Pontifex42/Walldraw/ESP32/Media/IMG_20220801_133036.jpg

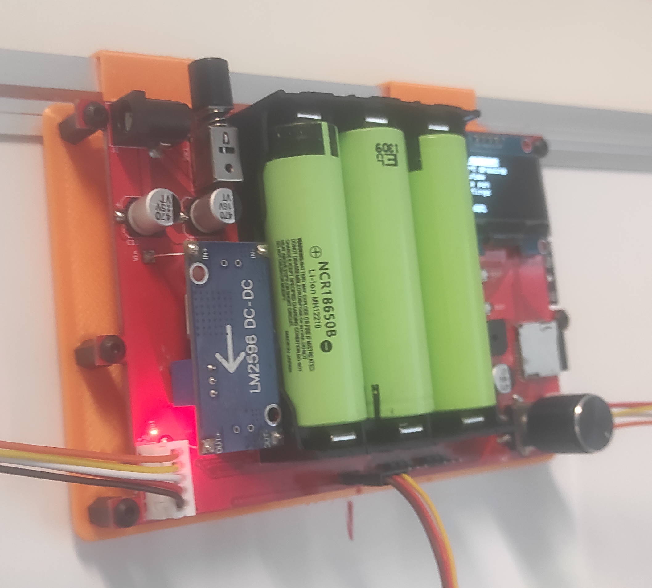
ESP32/Media/IMG_20220801_133036.jpg
