Pontifex42/Walldraw/README.md

# Walldraw
Vollständige Anleitung auf Deutsch ist in "Wandplotter.pdf".
Find a german manual in the file "Wandplotter.pdf".
