Pontifex42/Walldraw/ESP32/Media/IMG_20220804_125302.jpg

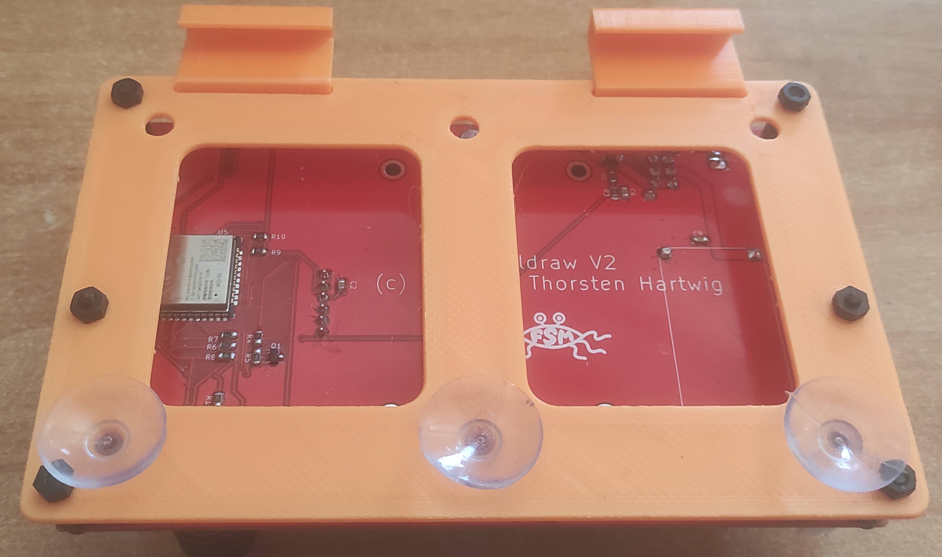
ESP32/Media/IMG_20220804_125302.jpg
