Pontifex42/Walldraw/Media/IMG_20220721_150740.jpg

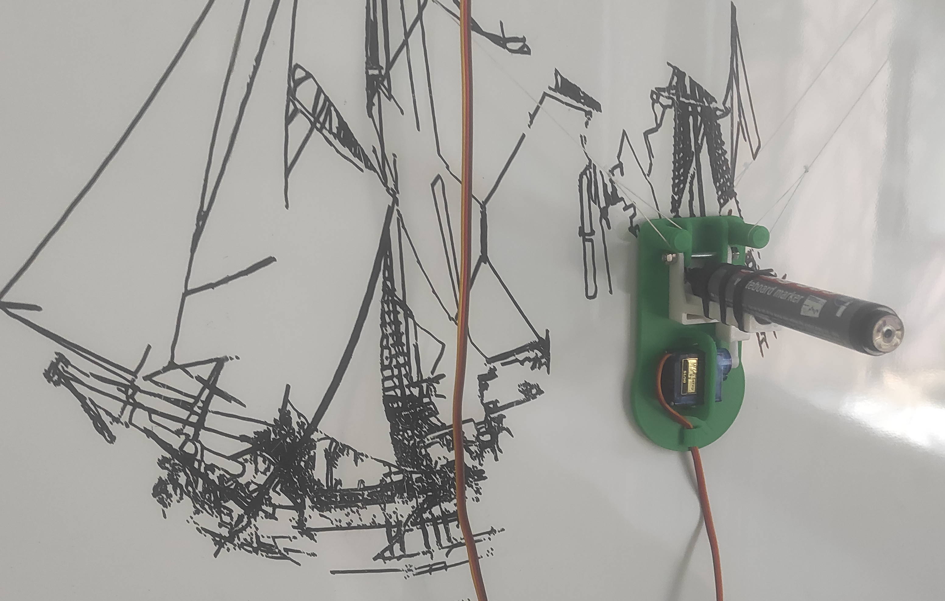
Media/IMG_20220721_150740.jpg
