Pontifex42/Walldraw/Media/IMG_20220801_133017.jpg

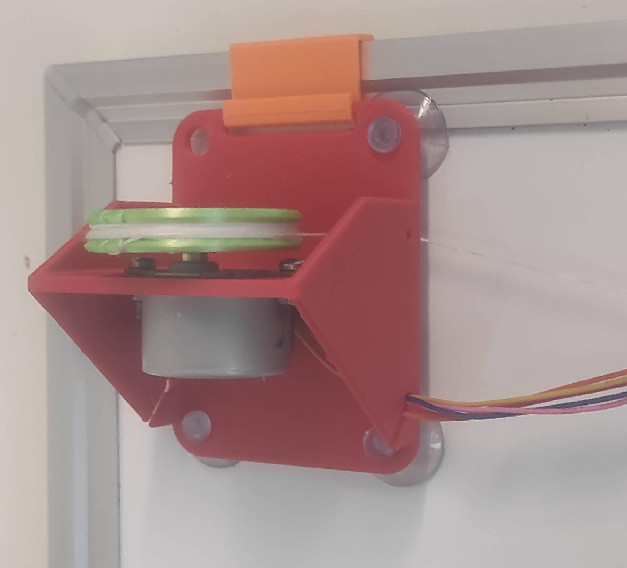
Media/IMG_20220801_133017.jpg
