Pontifex42/Walldraw/Media/IMG_20220801_133601.jpg

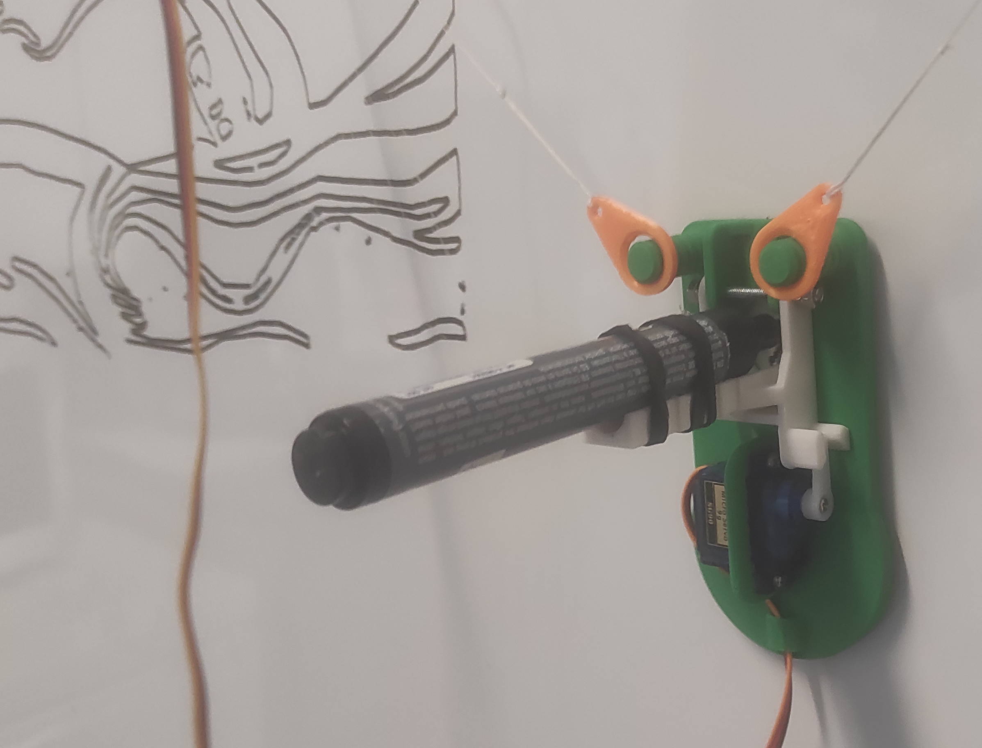
Media/IMG_20220801_133601.jpg
