Pontifex42/Walldraw/UNO/Media/IMG_20220723_133455.jpg

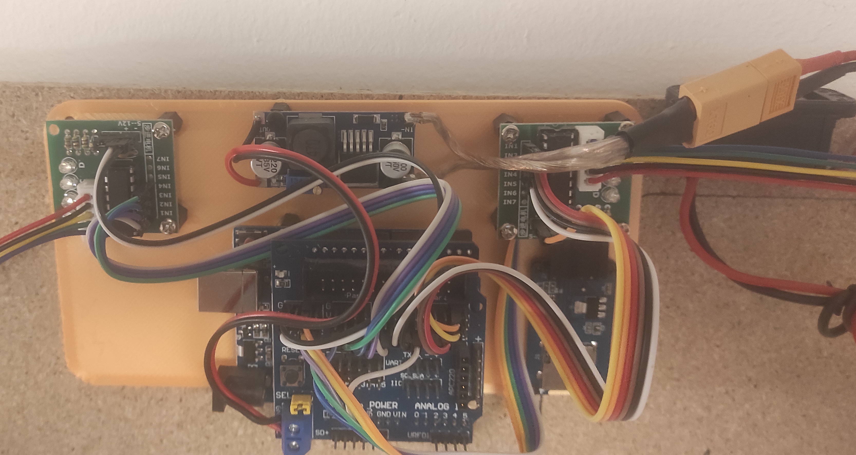
UNO/Media/IMG_20220723_133455.jpg
