Pontifex42/Walldraw/UNO/Media/IMG_20220723_133458.jpg

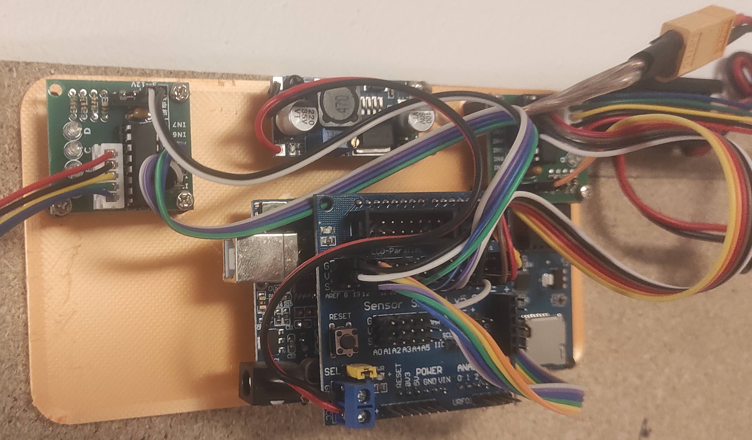
UNO/Media/IMG_20220723_133458.jpg
