Pontifex42/Walldraw/PartList.htm

 | Walldraw Parts List
 |  |  |  | Source
Both Variants
 | Servo Sledge | 1 |  | 3D-Printed
 | Pen Holder (Lever) | 1 |  | 3D-Printed
 | Stepper holder | 2 |  | 3D-Printed
 | Spool | 2 |  | 3D-Printed
 | Base plate (either UNO or ESP32 Variant) | 1 |  | 3D-Printed
 | Twine rings | 2 |  | 3D-Printed
 | Cable clamps | 4 |  | 3D-Printed
 | Hooks | 4 |  | 3D-Printed
 | Motor 28BYJ-48 5V | 2 |  | https://de.aliexpress.com/wholesale?&SearchText=28BYJ-48
 | Motor cable 50cm | 2 |  | https://de.aliexpress.com/item/4000407576136.html or solder yourself
 | Screws M3x10 | 6 |  | To attach motors and pen lever
 | Servo SG90 | 1 |  | https://de.aliexpress.com/wholesale?&SearchText=SG90
 | Servo cable 100cm | 1 |  | https://de.aliexpress.com/item/32902360371.html or solder yourself
 | PCB Mounting material kit | 1 |  | https://de.aliexpress.com/wholesale?&SearchText=pcb+mount+kit
 | Ink Pen | 1 |  | Any store
 | Twine 3m | 2 |  | Look in mummys sewing kit
 | Rubber straps to mount pen | 4 |  | Look in mummys sewing kit
 | microSD Card e.g. 2GB | 1 |  | Any electronics store
 | Sucker | 14 | Optional | https://de.aliexpress.com/wholesale?&SearchText=saugnapf
UNO Variant
 | Motor Driver Board ULN2003 | 2 |  | included in motor
 | microSD Card reader | 1 |  | https://de.aliexpress.com/item/32523546123.html
 | Arduino Uno R3 | 1 |  | https://de.aliexpress.com/item/1005002707450245.html
 | Arduino Sensor Shield V5.0 | 1 |  | https://de.aliexpress.com/item/32552605782.html
 | Screws <2mm x 3mm to mount SD cardreader | 2 |  | Hot glue may do a s well
 | 5V 2A Power Supply with DC Plug 5,5mm | 1 | Alternativ | https://de.aliexpress.com/wholesale?&SearchText=power+5V+5.5mm
 | LM2596 DC-DC Buck Converter 3A (also on ESP32 PCB) | 1 | Alternativ | https://de.aliexpress.com/item/32272430344.html
 | XT60 Connector, optional | 1 | Optional | https://de.aliexpress.com/item/32920591260.html
 | XT60 Switch, optional | 1 | Optional | https://de.aliexpress.com/item/1005001705864141.html
 | LiPo Battery 11,2V 2Ah w. XT60 Connector, optional | 1 | Alternativ
 | Don‘t forget you need a LiPo Charger | 1 | Optional
 | There is currently no plan for wiring. Look into code.
ESP32 variant
 | LiIon 18650 batteries (or 12V power supply) | 3 | Alternativ | https://de.aliexpress.com/wholesale?&SearchText=18650+panasonic
 | Alternativ: 12V 2A power supply with DC5.5mm connector | 1 | Alternativ | https://de.aliexpress.com/wholesale?&SearchText=power+DC+12V+2A+5.5mm
 | PCB, e.g. from JLCPCB or PCBWAY using contained Gerber files | 1 |  | https://jlcpcb.com/
 | PCB parts as listed in the file „ibom.html“, see there | A lot |  | See part list there
 | FTDI-Adapter 3.3V | 1 |  | https://de.aliexpress.com/wholesale?&SearchText=FTDI
Software
 | Arduino IDE |  |  | https://www.arduino.cc/
 | Alternativ: Microsoft Visual Studio and vsmicro extension |  | Optional | https://www.visualmicro.com/, 45Days trial, than $12/year
 | ESP32 Board Manager V2.x |  |  | Install using board manager of Arduino IDE
 | Inkscape |  |  | https://inkscape.org, Find tutorials to convert drawings to gcode on YT
 | Walldraw code from my github |  |  | https://github.com/Pontifex42/Walldraw
 | Picture resizer tool, use the generated executable |  |  | https://github.com/Pontifex42/Walldraw
