Pontifex42/Walldraw/3DFiles/TwineRing.stl

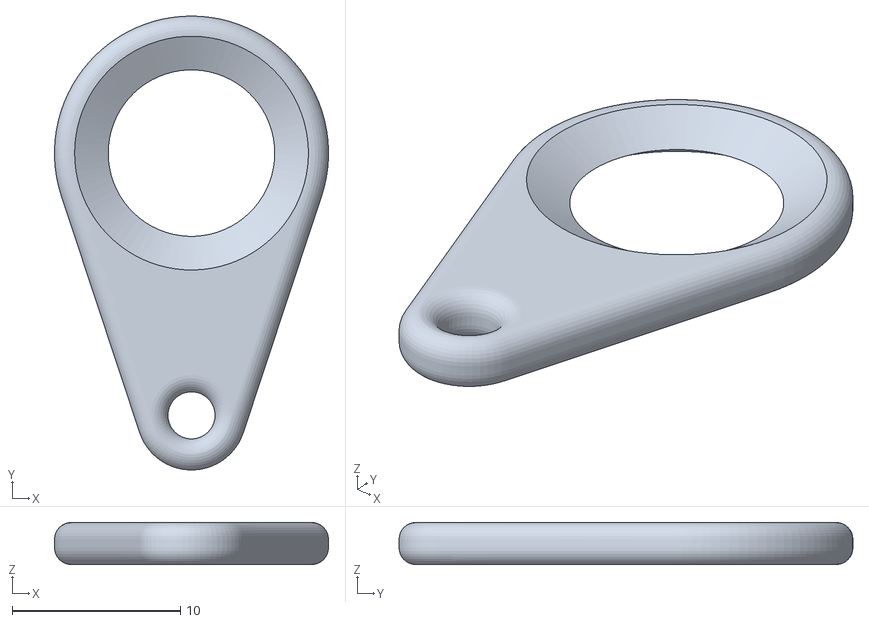
[picture p15: CAD file, 2022-08-04]
3DFiles/TwineRing.stl
16.3 x 27.0 x 2.50
