Pontifex42/Walldraw/3DFiles/StepperStand.stl

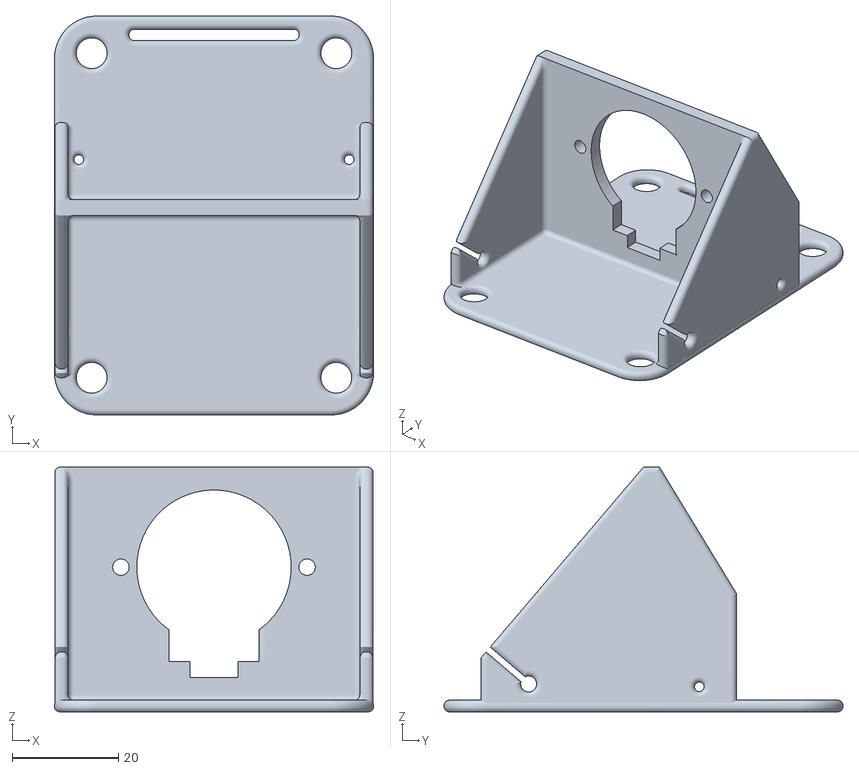
[picture p16: CAD file, 2022-08-04]
3DFiles/StepperStand.stl
60.0 x 75.0 x 46.0
