Pontifex42/Walldraw/3DFiles/Spool.stl

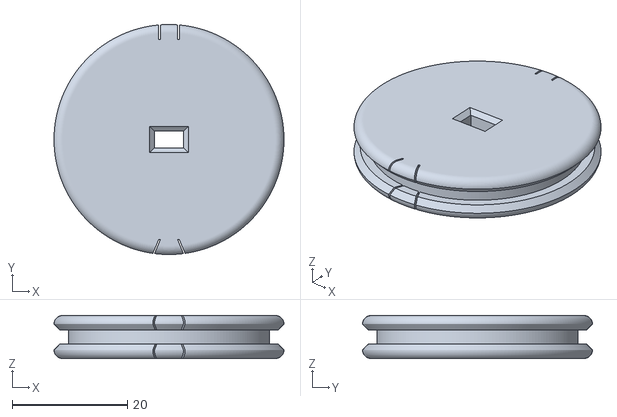
[picture p17: CAD file, 2022-08-04]
3DFiles/Spool.stl
40.0 x 40.0 x 7.50
