Pontifex42/Walldraw/3DFiles/Lever.stl

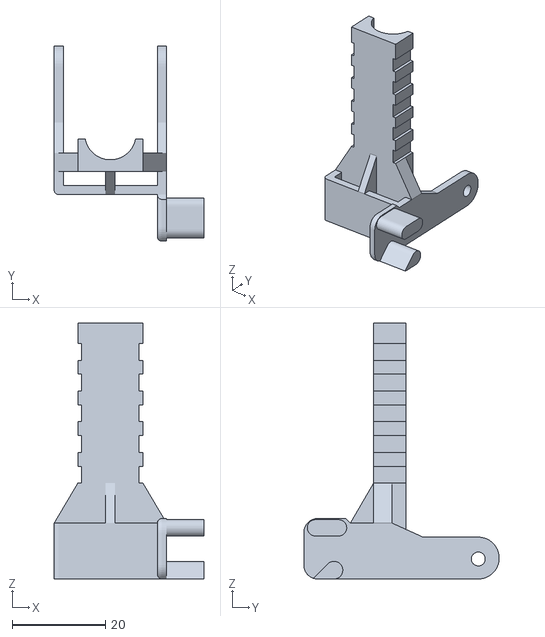
[picture p18: CAD file, 2022-08-04]
3DFiles/Lever.stl
32.2 x 42.0 x 55.0
