Pontifex42/Walldraw/3DFiles/WireClamp.stl

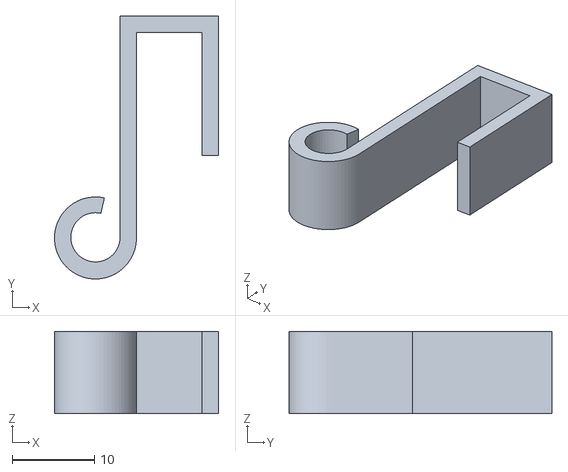
[picture p19: CAD file, 2022-08-04]
3DFiles/WireClamp.stl
20.0 x 32.1 x 10.0
