Pontifex42/Walldraw/3DFiles/Sledge.stl

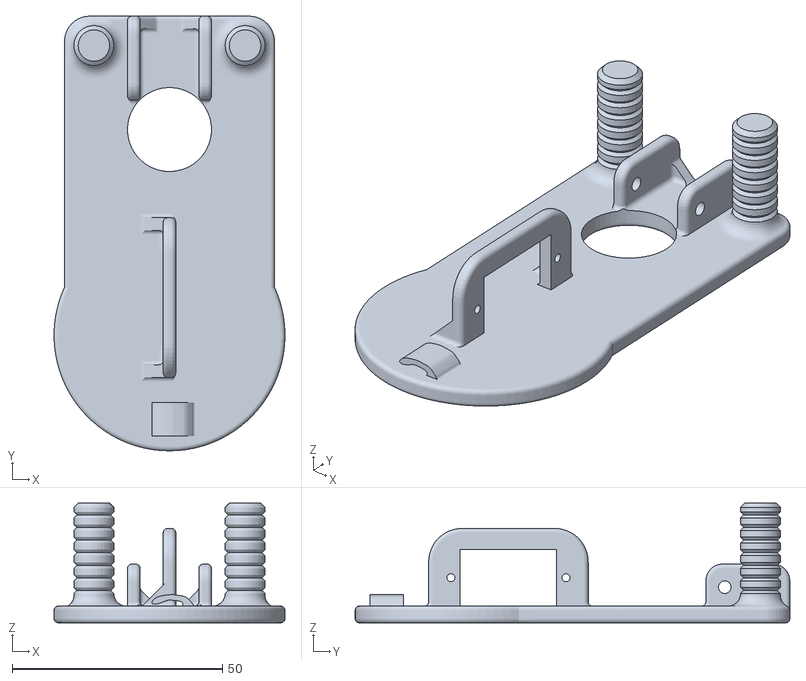
[picture p20: CAD file, 2022-08-04]
3DFiles/Sledge.stl
55.0 x 103.5 x 28.5
