Pontifex42/Walldraw/3DFiles/BasePlate Uno.stl

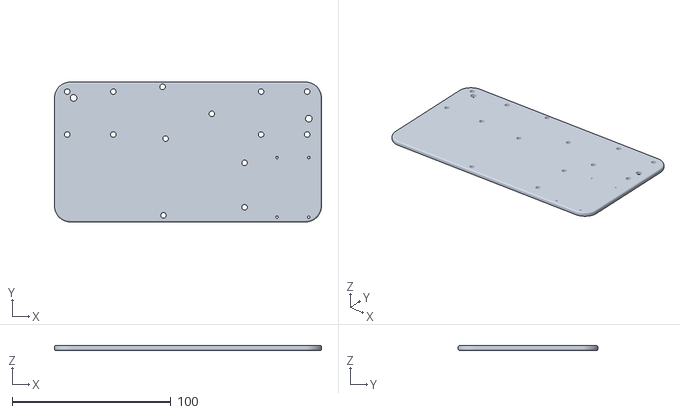
[picture p21: CAD file, 2022-08-04]
3DFiles/BasePlate Uno.stl
168.0 x 88.0 x 3.20
