Pontifex42/Walldraw/3DFiles/BasePlate PCB.stl

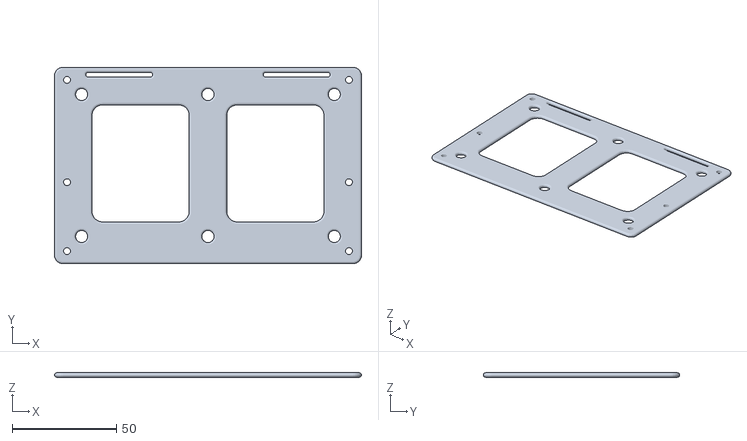
[picture p22: CAD file, 2022-08-04]
3DFiles/BasePlate PCB.stl
147.0 x 94.0 x 2.20
