Pontifex42/Walldraw/3DFiles/Hook.stl

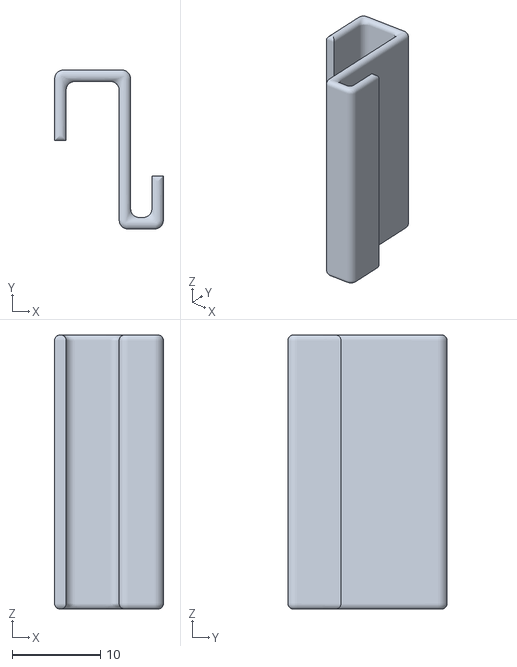
[picture p23: CAD file, 2022-08-04]
3DFiles/Hook.stl
12.3 x 18.0 x 31.0
