Pontifex42/Walldraw/(list of files, cad)

Other CAD files:
3DFiles/BasePlate.f3d
3DFiles/Sledge.f3d
3DFiles/Spool.f3d
3DFiles/StepperStand.f3d
3DFiles/WireClamp.f3d
