Pontifex42/Walldraw/ESP32/KiCad/WallDraw/WallDraw.kicad_pcb

## KiCad design ESP32/KiCad/WallDraw/WallDraw.kicad_pcb (2022-08-04)

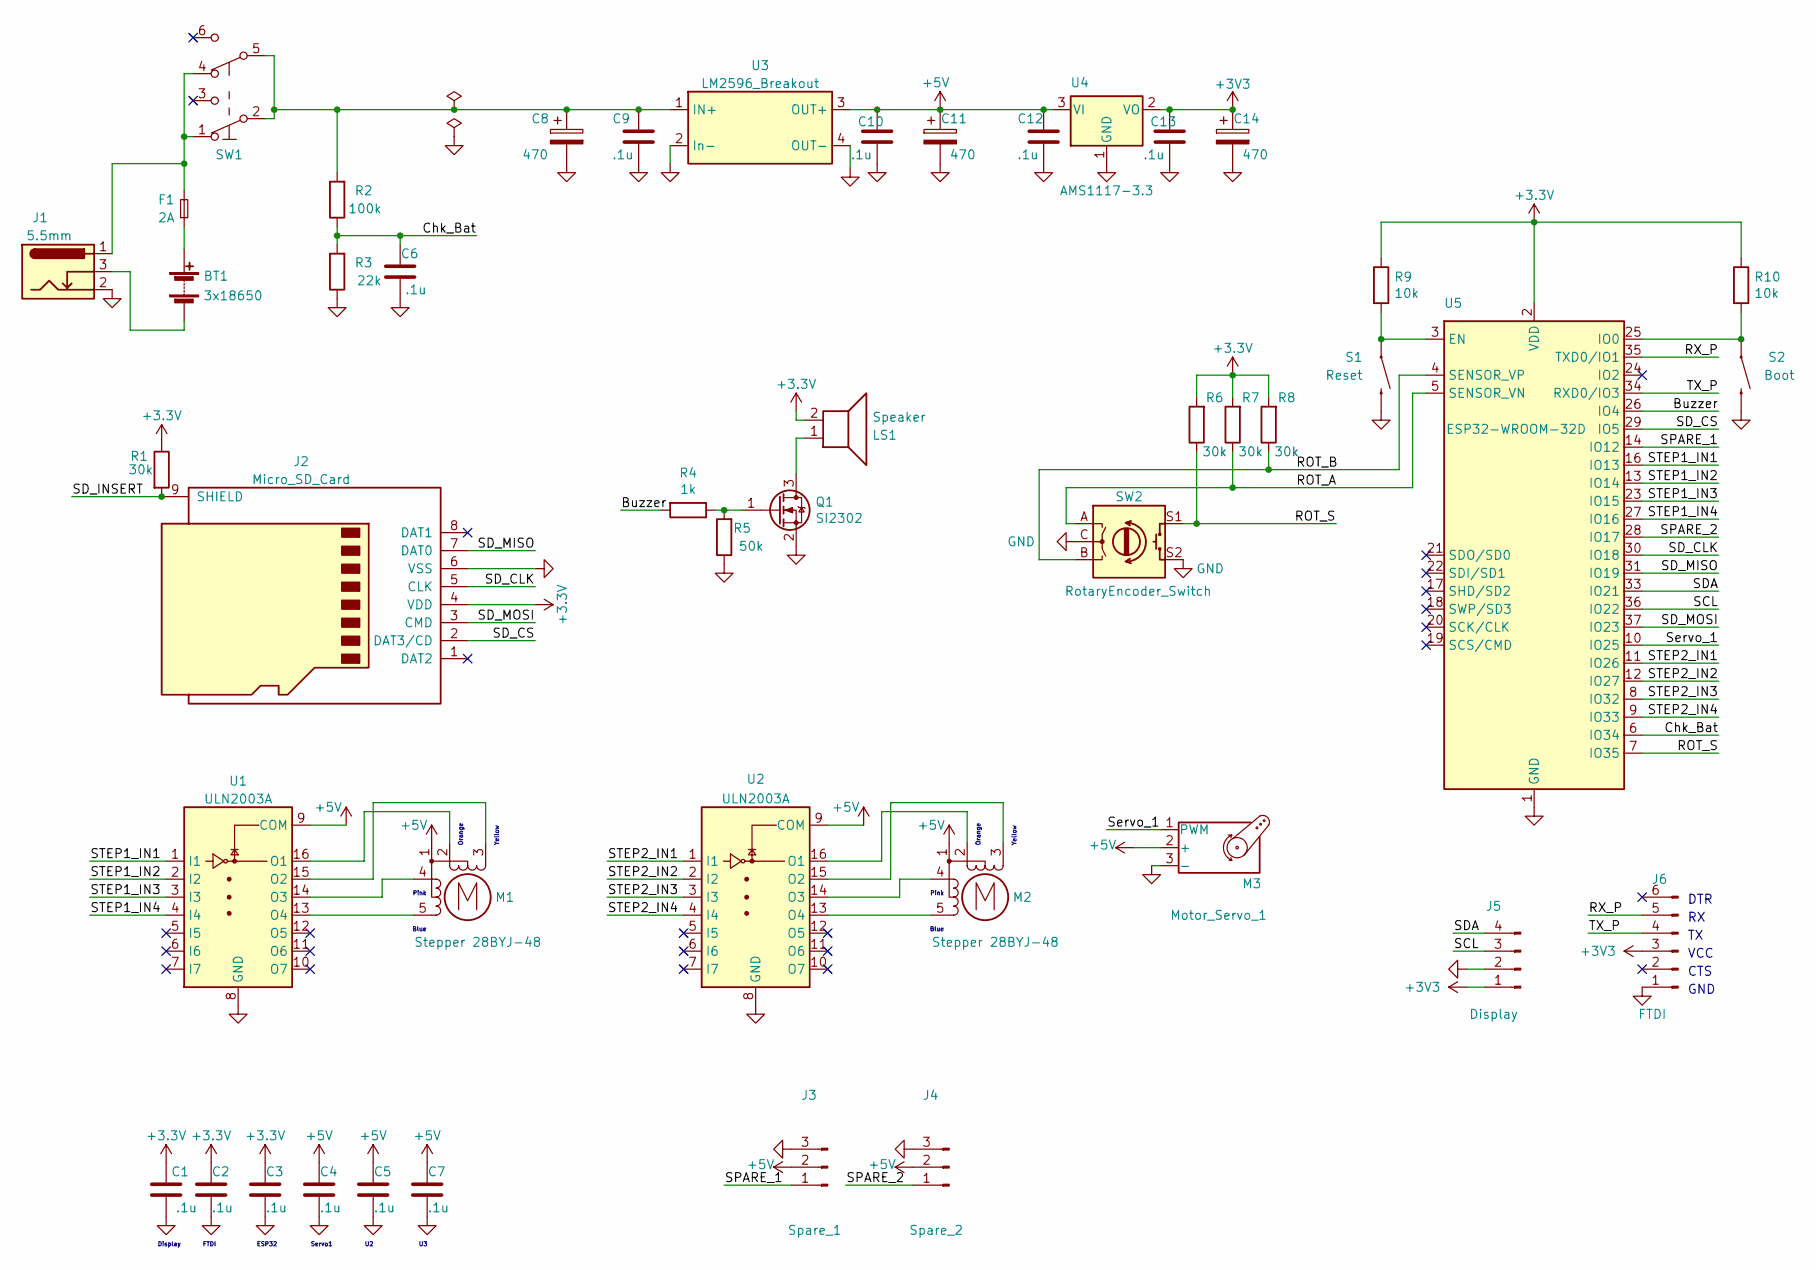
[picture p24: schematic WallDraw.kicad_sch, CO2 Ampel]

Parts:
BT1: 3x18650; LiIo18650x3_PCB_Mount
C1, C2, C3, C4, C5, C6, C7, C9, C10, C12, C13: .1u; C_0805_2012Metric_Pad1.18x1.45mm_HandSolder
C8, C11, C14: 470; CP_Elec_8x10.5
F1: 2A; Fuse_1206_3216Metric_Pad1.42x1.75mm_HandSolder
J1: 5.5mm; BarrelJack_Horizontal
J2: Micro_SD_Card; GCT-MEM2055-00-190-01-A
J3: Spare_1; PinHeader_1x03_P2.54mm_Vertical
J4: Spare_2; PinHeader_1x03_P2.54mm_Vertical
J5: Display; OLED_1.3
J6: FTDI; PinHeader_1x06_P2.54mm_Vertical
LS1: Speaker; HN9650B Buzzer
M1, M2: Stepper 28BYJ-48; JST_EH_B5B-EH-A_1x05_P2.50mm_Vertical
M3: Motor_Servo_1; PinHeader_1x03_P2.54mm_Vertical
Q1: SI2302; SOT-23
R1, R6, R7, R8: 30k; R_0805_2012Metric_Pad1.20x1.40mm_HandSolder
R2: 100k; R_0805_2012Metric_Pad1.20x1.40mm_HandSolder
R3: 22k; R_0805_2012Metric_Pad1.20x1.40mm_HandSolder
R4: 1k; R_0805_2012Metric_Pad1.20x1.40mm_HandSolder
R5: 50k; R_0805_2012Metric_Pad1.20x1.40mm_HandSolder
R9, R10: 10k; R_0805_2012Metric_Pad1.20x1.40mm_HandSolder
S1: Reset; TACTILE_SWITCH_SMD_6.0X3.5MM
S2: Boot; TACTILE_SWITCH_SMD_6.0X3.5MM
SW1: SW_Push_DPDT; PS-22F02
SW2: RotaryEncoder_Switch; EC11_Rotary_SMD
U1, U2: ULN2003A; SOP-16_3.9x9.9mm_P1.27mm
U3: LM2596_Breakout; BuckConverter_LM2596_Breakout
U4: AMS1117-3.3; SOT-223-3_TabPin2
U5: ESP32-WROOM-32D; ESP32-WROOM-32

Connections:
+5V: C4.1, C5.1, C7.1, C10.1, C11.1, C12.1, J3.2, J4.2, M1.1, M2.1, M3.2 (+), U1.9 (COM), U2.9 (COM), U3.3 (OUT+), U4.3 (VI)
/Buzzer: R4.2, U5.26 (IO4)
/Chk_Bat: C6.1, R2.1, R3.2, U5.6 (IO34)
/ROT_A: R7.1, SW2.A, U5.5 (SENSOR_VN)
/ROT_B: R8.1, SW2.B, U5.4 (SENSOR_VP)
/ROT_S: R6.1, SW2.S1, U5.7 (IO35)
/RX_P: J6.5, U5.35 (TXD0/IO1)
/SCL: J5.3, U5.36 (IO22)
/SDA: J5.4, U5.33 (IO21)
/SD_CLK: J2.5 (CLK), U5.30 (IO18)
/SD_CS: J2.2 (DAT3/CD), U5.29 (IO5)
/SD_INSERT: J2.9 (SHIELD), R1.2
/SD_MISO: J2.7 (DAT0), U5.31 (IO19)
/SD_MOSI: J2.3 (CMD), U5.37 (IO23)
/SPARE_1: J3.1, U5.14 (IO12)
/SPARE_2: J4.1, U5.28 (IO17)
/STEP1_IN1: U1.1 (I1), U5.16 (IO13)
/STEP1_IN2: U1.2 (I2), U5.13 (IO14)
/STEP1_IN3: U1.3 (I3), U5.23 (IO15)
/STEP1_IN4: U1.4 (I4), U5.27 (IO16)
/STEP2_IN1: U2.1 (I1), U5.11 (IO26)
/STEP2_IN2: U2.2 (I2), U5.12 (IO27)
/STEP2_IN3: U2.3 (I3), U5.8 (IO32)
/STEP2_IN4: U2.4 (I4), U5.9 (IO33)
/Servo_1: M3.1 (PWM), U5.10 (IO25)
/TX_P: J6.4, U5.34 (RXD0/IO3)
GND: C1.2, C2.2, C3.2, C4.2, C5.2, C6.2, C7.2, C8.2, C9.2, C10.2, C11.2, C12.2, C13.2, C14.2, J1.2, J2.6 (VSS), J3.3, J4.3, J5.2, J6.1, M3.3 (-), Q1.2 (S), R3.1, R5.1, S1.2, S2.2, SW2.C, SW2.S2, U1.8 (GND), U2.8 (GND), U3.2 (In-), U3.4 (OUT-), U4.1 (GND), U5.1 (GND), U5.15 (GND), U5.38 (GND), U5.39 (GND)
unnamed: BT1.1 (+), F1.1
unnamed: BT1.6 (-), J1.3
unnamed: C8.1, C9.1, R2.2, SW1.2, SW1.5, U3.1 (IN+)
unnamed: F1.2, J1.1, SW1.1, SW1.4
unnamed: LS1.1, Q1.3 (D)
unnamed: M1.2, U1.16 (O1)
unnamed: M1.3 (-), U1.15 (O2)
unnamed: M1.4, U1.14 (O3)
unnamed: M1.5, U1.13 (O4)
unnamed: M2.2, U2.16 (O1)
unnamed: M2.3 (-), U2.15 (O2)
unnamed: M2.4, U2.14 (O3)
unnamed: M2.5, U2.13 (O4)
unnamed: Q1.1 (G), R4.1, R5.2
unnamed: R9.2, S1.1, U5.3 (EN)
unnamed: R10.2, S2.1, U5.25 (IO0)

Notes on the sheet:
CTS
Yellow
Pink
Blue
VCC
ESP32
Orange
Display
GND
FTDI
DTR
Servo1

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
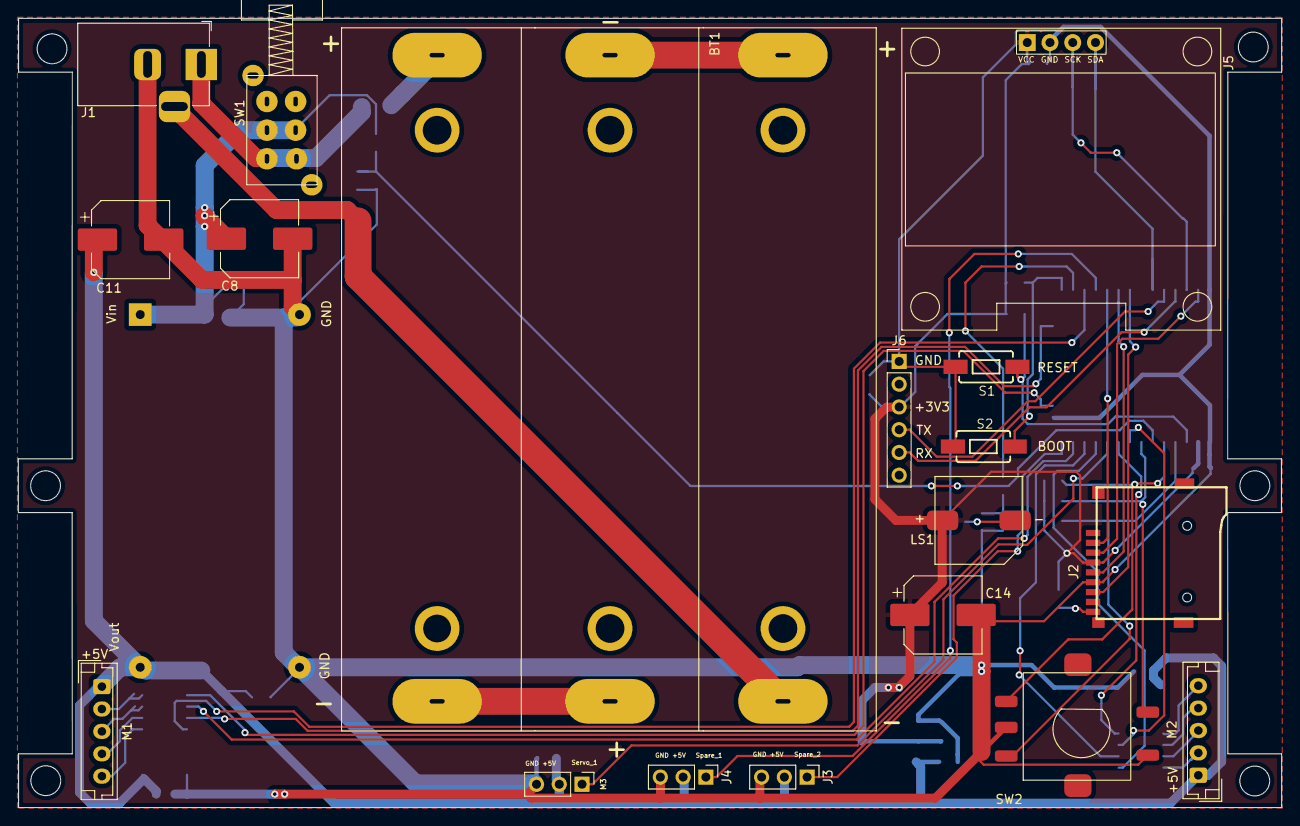
[picture p25: board WallDraw.kicad_pcb from above]

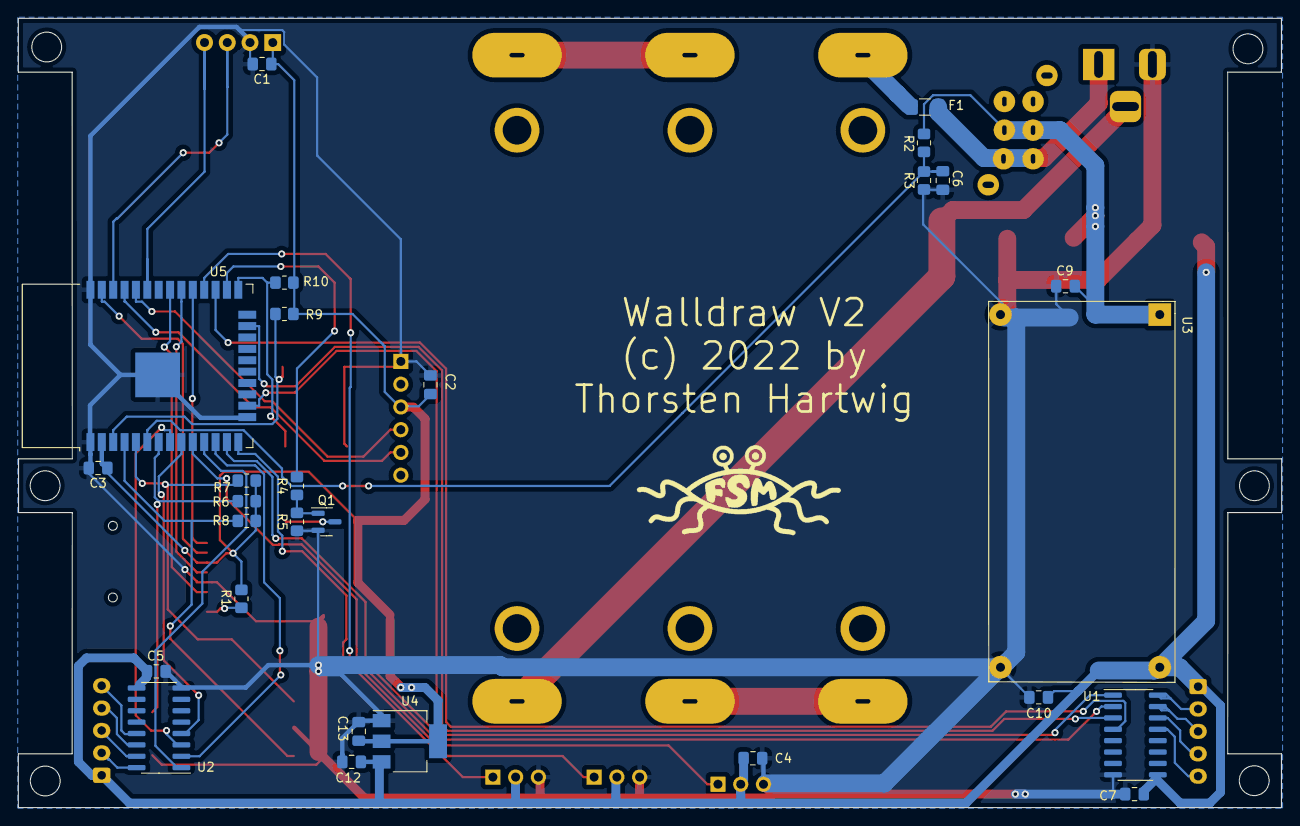
[picture p26: board WallDraw.kicad_pcb from below]

Board: 2 copper layers, 141.0 x 88.1 mm, 46 parts (28 on the bottom side), 44 nets.
