Pontifex42/Walldraw/(notices)

Notices in the files:
ESP32/KiCad/WallDraw/WallDraw.kicad_pcb:
(c) 2022 by
Thorsten Hartwig
